dlgus0630/Project05_RS422Failover/docs/verification/simulation_summary.txt

tb_axi_lite_regs: PASS
tb_channel_health_mgr: PASS
tb_crc16_ccitt: PASS
tb_decision_unit: PASS
tb_duplicate_guard: PASS
tb_event_arbiter: PASS
tb_event_fifo: PASS
tb_fail_count_per_transaction: PASS
tb_frame_fifo: PASS
tb_frame_parser: PASS
tb_pair_matcher: PASS
tb_raw_frame_buffer: PASS
tb_redundant_link_core: PASS
tb_seq_monitor: PASS
tb_status_display: PASS
tb_uart_rx: PASS
tb_uart_tx: PASS
